devb-db/stm32_controller_v3/STM32_Controller_v3/STM32_Controller_v3.kicad_pcb

## KiCad design STM32_Controller_v3/STM32_Controller_v3.kicad_pcb (2026-06-17)

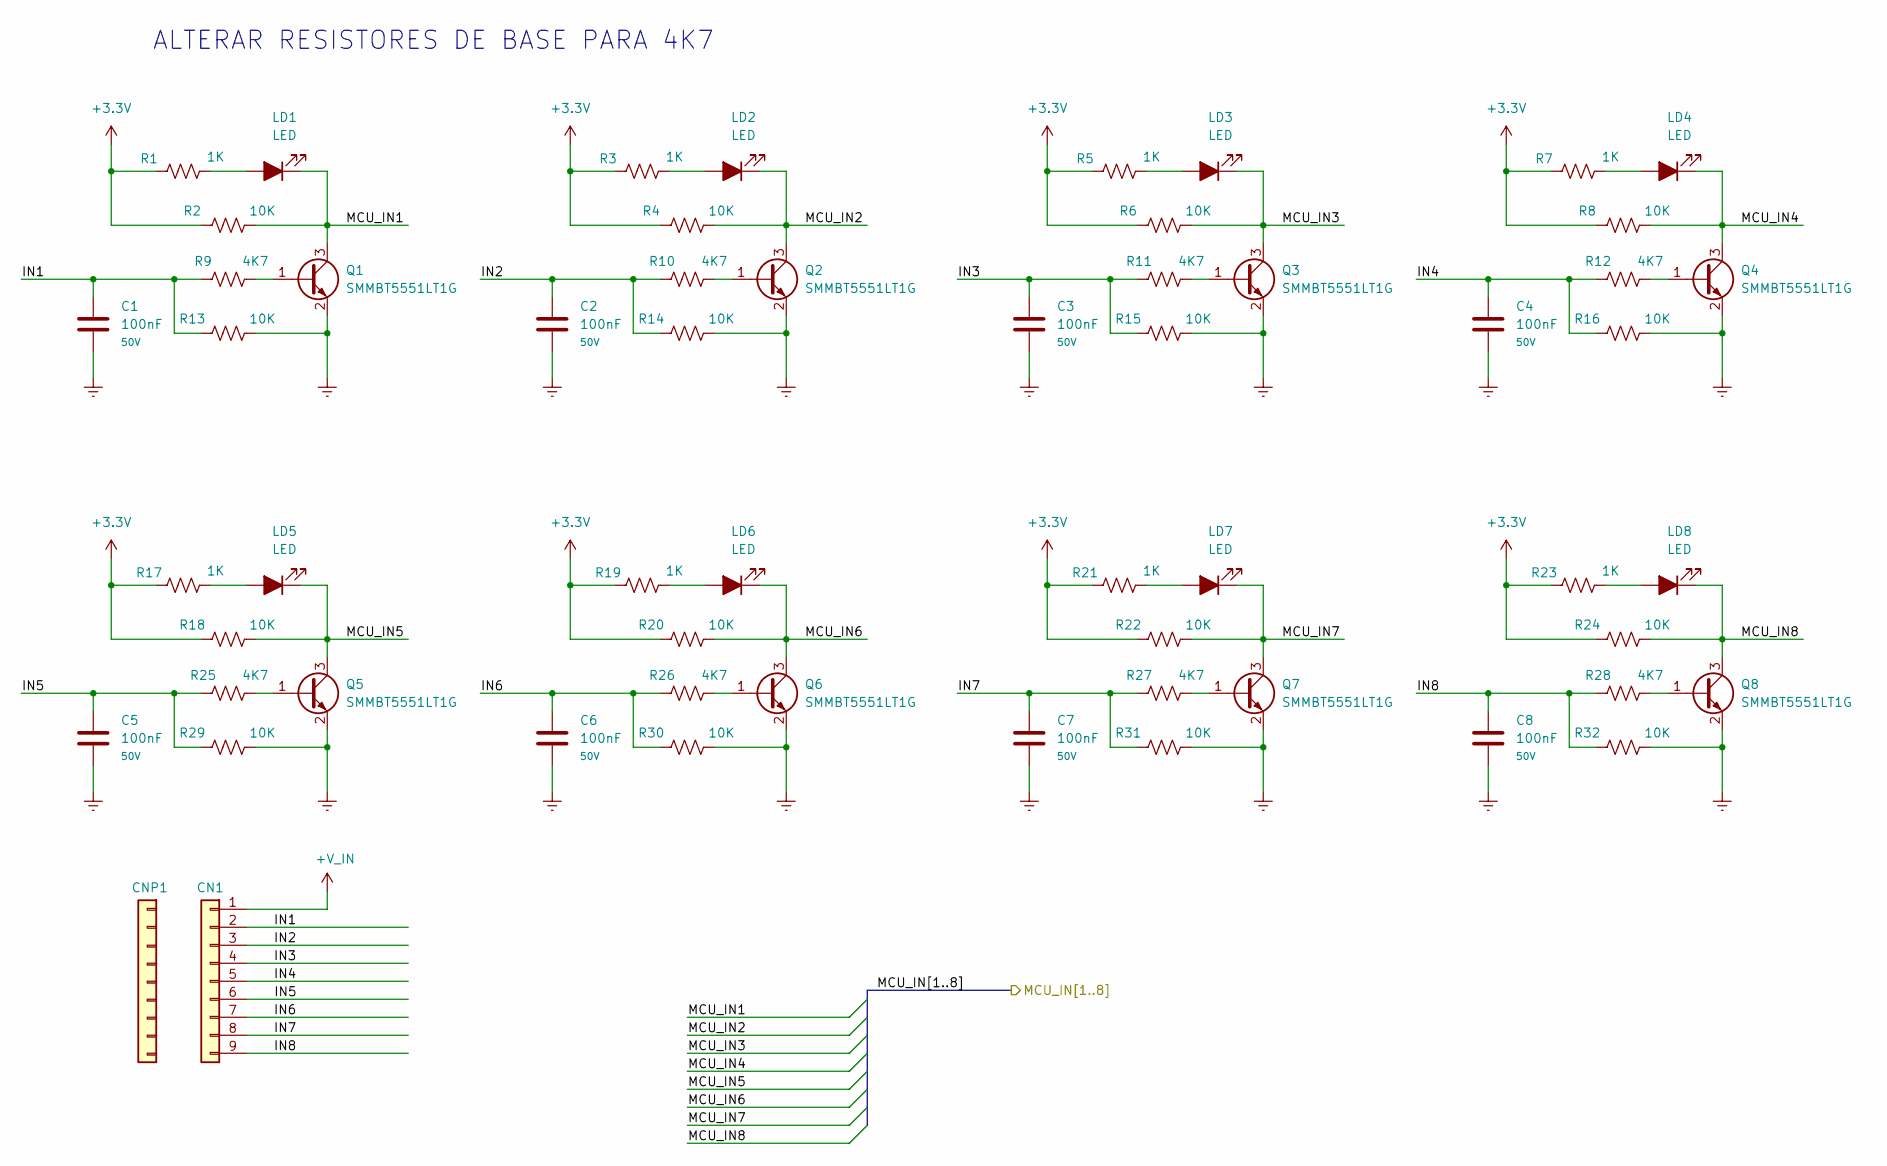
[picture p1: schematic Inputs_sch.kicad_sch]

Parts:
C1, C2, C3, C4, C5, C6, C7, C8: 100nF; C_0805; Voltage 50V; Part.Number CC0805KRX7R9BB104; LCSC Part C49678
CN1: WJ15EDGVC-3.81-09P-14-00A; PhoenixContact_MCV_1,5_9-G-3.81_1x09_P3.81mm_Vertical; Part.Number WJ15EDGVC-3.81-09P-14-00A; LCSC Part C49737
CNP1: WJ15EDGK-3.81-09P-14-00A; Part.Number WJ15EDGK-3.81-09P-14-00A; LCSC Part C31287
LD1, LD2, LD3, LD4, LD5, LD6, LD7, LD8: LED; LED_0805_2012Metric; Part.Number NCD0805R1; LCSC Part C84256
Q1, Q2, Q3, Q4, Q5, Q6, Q7, Q8: SMMBT5551LT1G; TSOT-23; Part.Number MMBT5551; LCSC Part C2145
R1, R3, R5, R7, R17, R19, R21, R23: 1K; R_0805; Part.Number 0805W8F1001T5E; LCSC Part C17513
R2, R4, R6, R8, R13, R14, R15, R16, R18, R20, R22, R24, R29, R30, R31, R32: 10K; R_0805; Part.Number 0805W8F1002T5E; LCSC Part C17414
R9, R10, R11, R12, R25, R26, R27, R28: 4K7; R_0805; LCSC Part C17673

Connections:
+3.3V: R1.1, R2.1, R3.1, R4.1, R5.1, R6.1, R7.1, R8.1, R17.1, R18.1, R19.1, R20.1, R21.1, R22.1, R23.1, R24.1; also elsewhere on the board
+V_IN: CN1.1; also elsewhere on the board
/Inputs/IN1: C1.1, CN1.2, R9.1, R13.1
/Inputs/IN2: C2.1, CN1.3, R10.1, R14.1
/Inputs/IN3: C3.1, CN1.4, R11.1, R15.1
/Inputs/IN4: C4.1, CN1.5, R12.1, R16.1
/Inputs/IN5: C5.1, CN1.6, R25.1, R29.1
/Inputs/IN6: C6.1, CN1.7, R26.1, R30.1
/Inputs/IN7: C7.1, CN1.8, R27.1, R31.1
/Inputs/IN8: C8.1, CN1.9, R28.1, R32.1
/Inputs/MCU_IN1: LD1.1 (K), Q1.3 (C), R2.2; also elsewhere on the board
/Inputs/MCU_IN2: LD2.1 (K), Q2.3 (C), R4.2; also elsewhere on the board
/Inputs/MCU_IN3: LD3.1 (K), Q3.3 (C), R6.2; also elsewhere on the board
/Inputs/MCU_IN4: LD4.1 (K), Q4.3 (C), R8.2; also elsewhere on the board
/Inputs/MCU_IN5: LD5.1 (K), Q5.3 (C), R18.2; also elsewhere on the board
/Inputs/MCU_IN6: LD6.1 (K), Q6.3 (C), R20.2; also elsewhere on the board
/Inputs/MCU_IN7: LD7.1 (K), Q7.3 (C), R22.2; also elsewhere on the board
/Inputs/MCU_IN8: LD8.1 (K), Q8.3 (C), R24.2; also elsewhere on the board
GND: C1.2, C2.2, C3.2, C4.2, C5.2, C6.2, C7.2, C8.2, Q1.2 (E), Q2.2 (E), Q3.2 (E), Q4.2 (E), Q5.2 (E), Q6.2 (E), Q7.2 (E), Q8.2 (E), R13.2, R14.2, R15.2, R16.2, R29.2, R30.2, R31.2, R32.2; also elsewhere on the board
unnamed: LD1.2 (A), R1.2
unnamed: LD2.2 (A), R3.2
unnamed: LD3.2 (A), R5.2
unnamed: LD4.2 (A), R7.2
unnamed: LD5.2 (A), R17.2
unnamed: LD6.2 (A), R19.2
unnamed: LD7.2 (A), R21.2
unnamed: LD8.2 (A), R23.2
unnamed: Q1.1 (B), R9.2
unnamed: Q2.1 (B), R10.2
unnamed: Q3.1 (B), R11.2
unnamed: Q4.1 (B), R12.2
unnamed: Q5.1 (B), R25.2
unnamed: Q6.1 (B), R26.2
unnamed: Q7.1 (B), R27.2
unnamed: Q8.1 (B), R28.2

Notes on the sheet:
ALTERAR RESISTORES DE BASE PARA 4K7

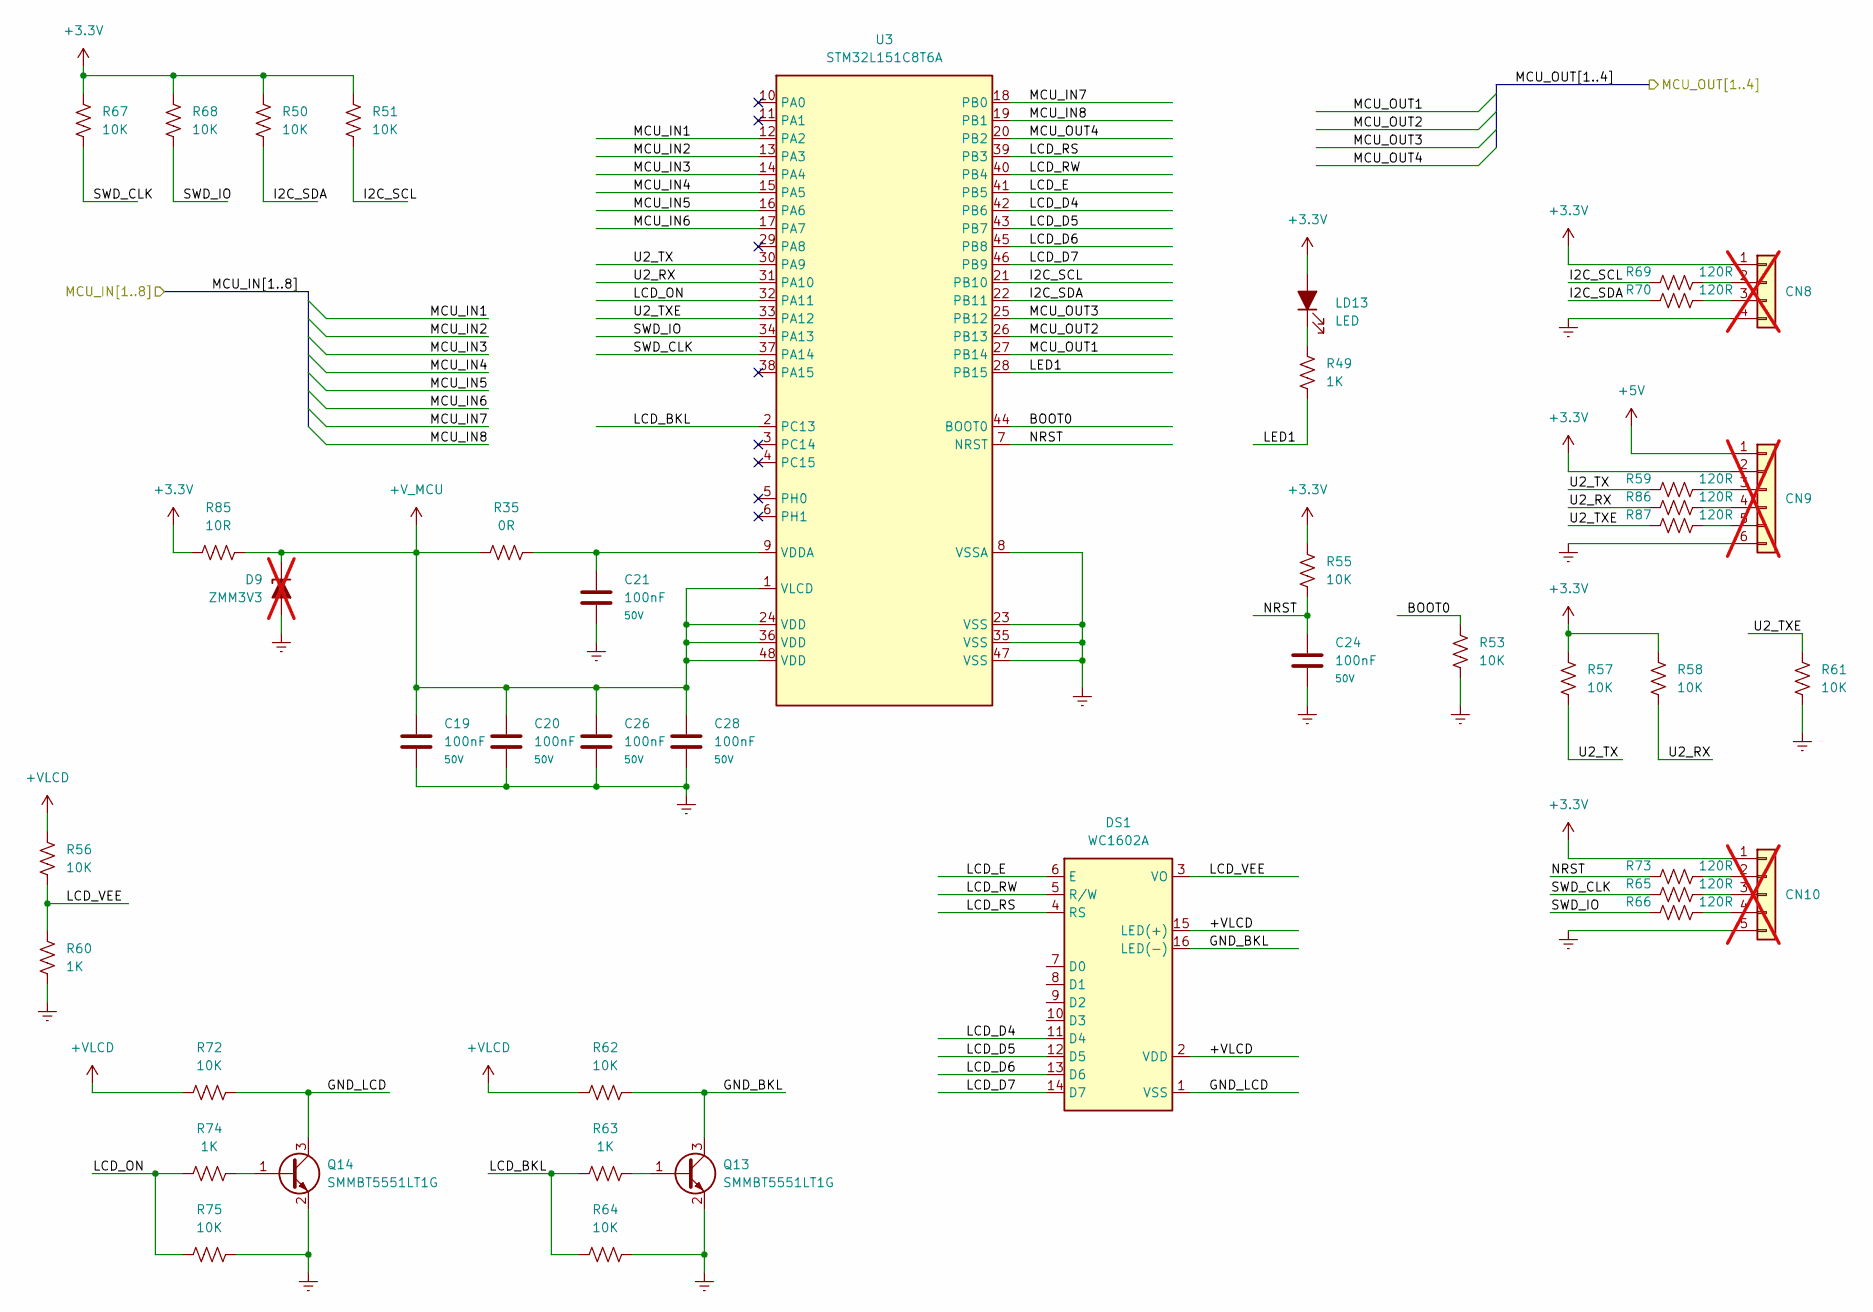
[picture p2: schematic Mcu_Stm32_sch.kicad_sch]

Parts:
C19, C20, C21, C24, C26, C28: 100nF; C_0805; Voltage 50V; Part.Number CC0805KRX7R9BB104; LCSC Part C49678
CN8: DS1021-1x4SF11-B; PinHeader_1x04_P2.54mm_Vertical; LCSC Part C7430360; not fitted
CN9: DS1021-1x6SF11-B; PinHeader_1x06_P2.54mm_Vertical; LCSC Part C7430362; not fitted
CN10: DS1021-1x5SF11-B; PinHeader_1x05_P2.54mm_Vertical; LCSC Part C7430361; not fitted
D9: ZMM3V3; D_MiniMELF; LCSC Part C8056; not fitted
DS1: WC1602A; Part.Number MGD1602A-NSW-BBS-01
LD13: LED; LED_0805_2012Metric; Part.Number NCD0805R1; LCSC Part C84256
Q13, Q14: SMMBT5551LT1G; TSOT-23; Part.Number MMBT5551; LCSC Part C2145
R35: 0R; R_0805; Part.Number 0805W8F0000T5E; LCSC Part C17477
R49, R60, R63, R74: 1K; R_0805; Part.Number 0805W8F1001T5E; LCSC Part C17513
R50, R51, R53, R55, R56, R57, R58, R61, R62, R64, R67, R68, R72, R75: 10K; R_0805; Part.Number 0805W8F1002T5E; LCSC Part C17414
R59, R65, R66, R69, R70, R73, R86, R87: 120R; R_0805; Part.Number 0805W8F1200T5E; LCSC Part C17437
R85: 10R; R_0805; Part.Number 0805W8F100JT5E; LCSC Part C17415
U3: STM32L151C8T6A; LQFP-48_7x7mm_P0.5mm; Part.Number STM32L151C8T6; LCSC Part C9861

Connections:
+3.3V: CN8.1, CN9.2, CN10.1, LD13.2 (A), R50.1, R51.1, R55.1, R57.1, R58.1, R67.1, R68.1, R85.1; also elsewhere on the board
+5V: CN9.1; also elsewhere on the board
+VLCD: DS1.2 (VDD), DS1.15 (LED(+)), R56.1, R62.1, R72.1; also elsewhere on the board
+V_MCU: C19.1, C20.1, C26.1, C28.1, D9.1 (K), R35.1, R85.2, U3.1 (VLCD), U3.24 (VDD), U3.36 (VDD), U3.48 (VDD)
/Inputs/MCU_IN1: U3.12 (PA2); also elsewhere on the board
/Inputs/MCU_IN2: U3.13 (PA3); also elsewhere on the board
/Inputs/MCU_IN3: U3.14 (PA4); also elsewhere on the board
/Inputs/MCU_IN4: U3.15 (PA5); also elsewhere on the board
/Inputs/MCU_IN5: U3.16 (PA6); also elsewhere on the board
/Inputs/MCU_IN6: U3.17 (PA7); also elsewhere on the board
/Inputs/MCU_IN7: U3.18 (PB0); also elsewhere on the board
/Inputs/MCU_IN8: U3.19 (PB1); also elsewhere on the board
/Mcu_Stm32/BOOT0: R53.1, U3.44 (BOOT0)
/Mcu_Stm32/GND_BKL: DS1.16 (LED(-)), Q13.3 (C), R62.2
/Mcu_Stm32/GND_LCD: DS1.1 (VSS), Q14.3 (C), R72.2
/Mcu_Stm32/I2C_SCL: R51.2, R69.1, U3.21 (PB10)
/Mcu_Stm32/I2C_SDA: R50.2, R70.1, U3.22 (PB11)
/Mcu_Stm32/LCD_BKL: R63.1, R64.1, U3.2 (PC13)
/Mcu_Stm32/LCD_D4: DS1.11 (D4), U3.42 (PB6)
/Mcu_Stm32/LCD_D5: DS1.12 (D5), U3.43 (PB7)
/Mcu_Stm32/LCD_D6: DS1.13 (D6), U3.45 (PB8)
/Mcu_Stm32/LCD_D7: DS1.14 (D7), U3.46 (PB9)
/Mcu_Stm32/LCD_E: DS1.6 (E), U3.41 (PB5)
/Mcu_Stm32/LCD_ON: R74.1, R75.1, U3.32 (PA11)
/Mcu_Stm32/LCD_RS: DS1.4 (RS), U3.39 (PB3)
/Mcu_Stm32/LCD_RW: DS1.5 (R/W), U3.40 (PB4)
/Mcu_Stm32/LCD_VEE: DS1.3 (VO), R56.2, R60.1
/Mcu_Stm32/LED1: R49.2, U3.28 (PB15)
/Mcu_Stm32/MCU_OUT1: U3.27 (PB14); also elsewhere on the board
/Mcu_Stm32/MCU_OUT2: U3.26 (PB13); also elsewhere on the board
/Mcu_Stm32/MCU_OUT3: U3.25 (PB12); also elsewhere on the board
/Mcu_Stm32/MCU_OUT4: U3.20 (PB2); also elsewhere on the board
/Mcu_Stm32/NRST: C24.1, R55.2, R73.1, U3.7 (NRST)
/Mcu_Stm32/SWD_CLK: R65.1, R67.2, U3.37 (PA14)
/Mcu_Stm32/SWD_IO: R66.1, R68.2, U3.34 (PA13)
/Mcu_Stm32/U2_RX: R58.2, R86.1, U3.31 (PA10)
/Mcu_Stm32/U2_TX: R57.2, R59.1, U3.30 (PA9)
/Mcu_Stm32/U2_TXE: R61.2, R87.1, U3.33 (PA12)
GND: C19.2, C20.2, C21.2, C24.2, C26.2, C28.2, CN8.4, CN9.6, CN10.5, D9.2 (A), Q13.2 (E), Q14.2 (E), R53.2, R60.2, R61.1, R64.2, R75.2, U3.8 (VSSA), U3.23 (VSS), U3.35 (VSS), U3.47 (VSS); also elsewhere on the board
unnamed: CN8.2, R69.2
unnamed: CN8.3, R70.2
unnamed: CN9.3, R59.2
unnamed: CN9.4, R86.2
unnamed: CN9.5, R87.2
unnamed: CN10.2, R73.2
unnamed: CN10.3, R65.2
unnamed: CN10.4, R66.2
unnamed: LD13.1 (K), R49.1
unnamed: Q13.1 (B), R63.2
unnamed: Q14.1 (B), R74.2
unnamed: C21.1, R35.2, U3.9 (VDDA)

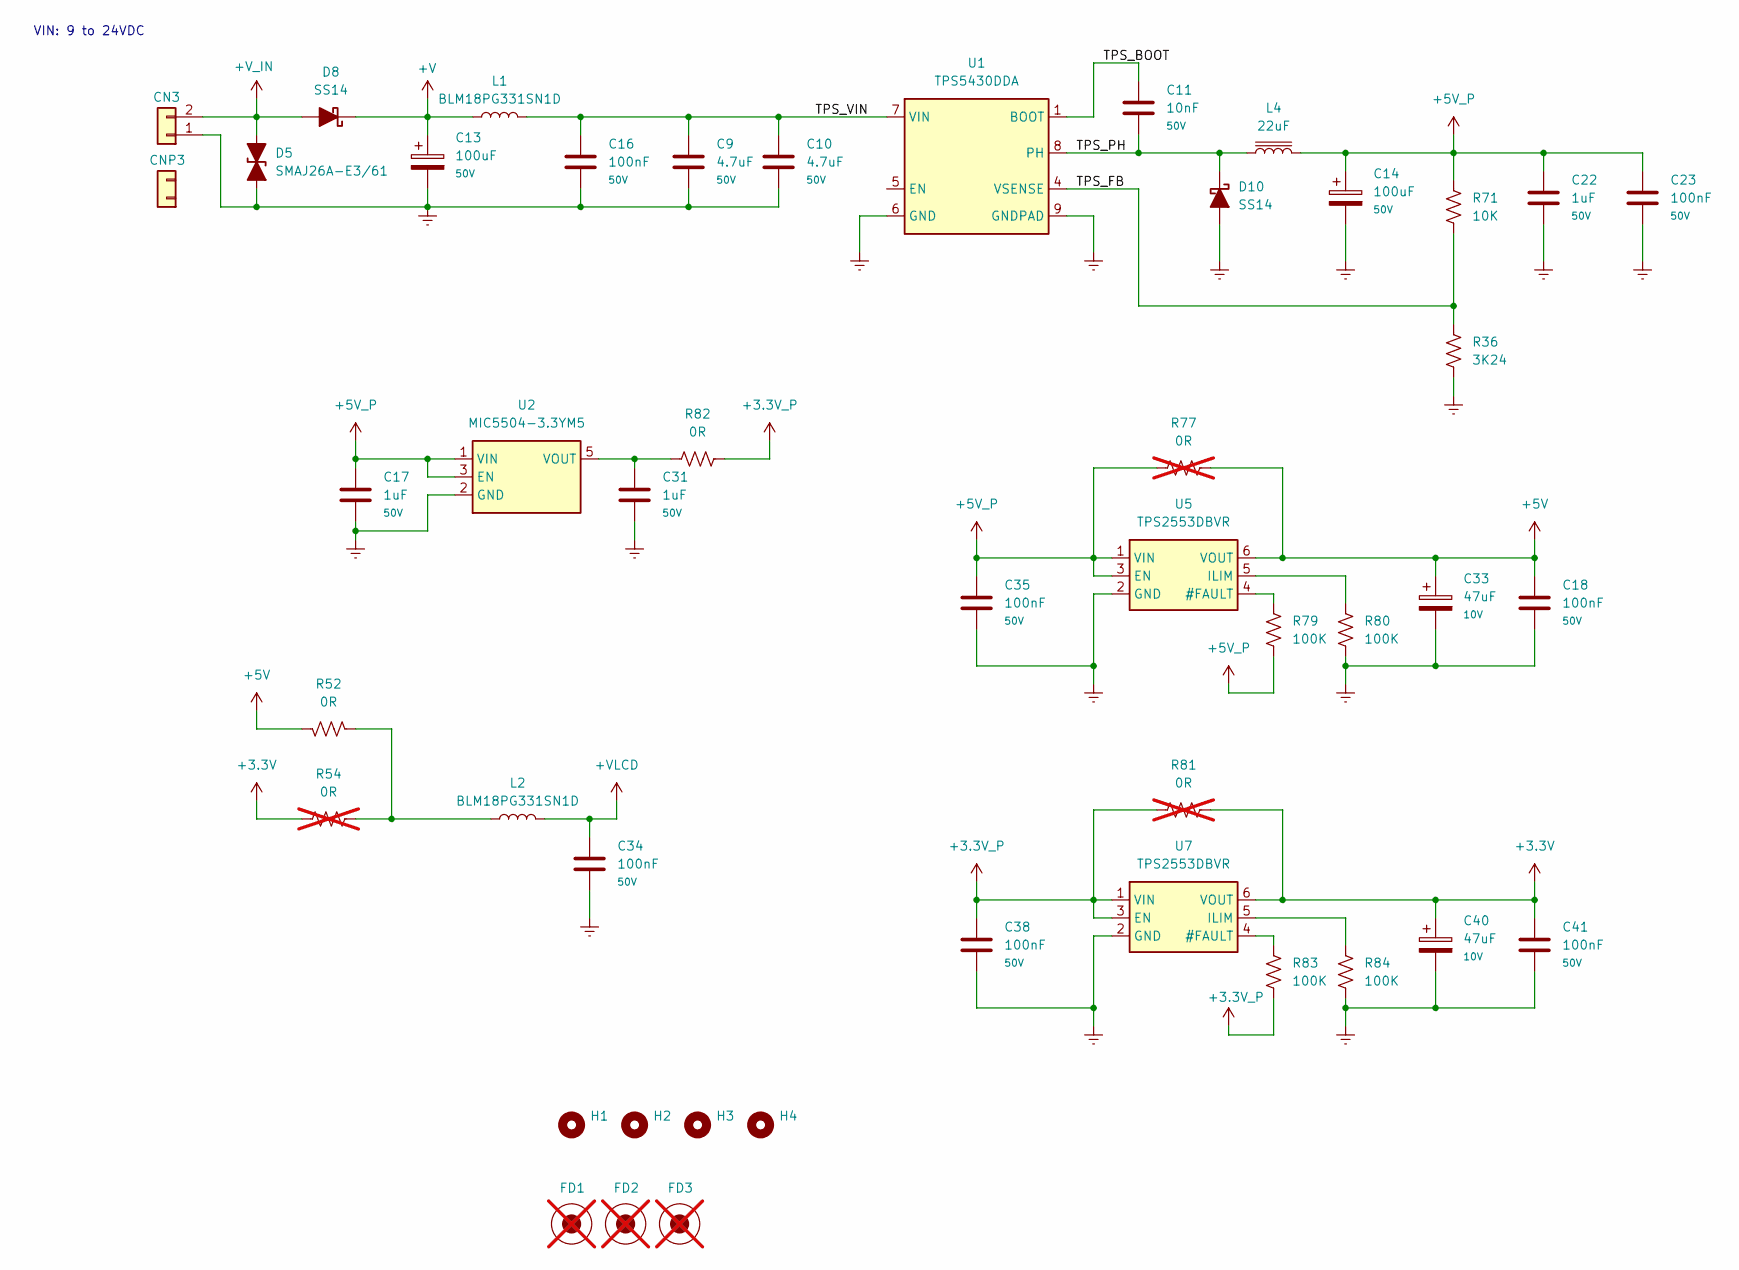
[picture p3: schematic Power_Supply_sch.kicad_sch]

Parts:
C9, C10: 4.7uF; C_1206; Voltage 50V; Part.Number 1206B475K500NT; LCSC Part C29823
C11: 10nF; C_0805; Voltage 50V; Part.Number CL21B103KBANNNC; LCSC Part C1710
C13, C14: 100uF; CP_Elec_8x10; Voltage 50V; Part.Number VEJ101M1HTR-0810L; LCSC Part C134502
C16, C18, C23, C34, C35, C38, C41: 100nF; C_0805; Voltage 50V; Part.Number CC0805KRX7R9BB104; LCSC Part C49678
C17, C22, C31: 1uF; C_0805; Voltage 50V; Part.Number CL21B105KBFNNNE; LCSC Part C28323
C33, C40: 47uF; CP_3528-CaseB; Voltage 10V; Part.Number TPSB476K010R0350; LCSC Part C444792
CN3: WJ15EDGVC-3.81-02P-14-00A; PhoenixContact_MCV_1,5_2-G-3.81_1x02_P3.81mm_Vertical; Part.Number WJ15EDGVC-3.81-02P-14-00A; LCSC Part C8396
CNP3: WJ15EDGK-3.81-02P-14-00A; Part.Number WJ15EDGK-3.81-02P-14-00A; LCSC Part C8466
D5: SMAJ26A-E3/61; D_SMA; Part.Number SMAJ26A; LCSC Part C49370
D8, D10: SS14; D_SMA; Part.Number SS14; LCSC Part C2480
FD1, FD2, FD3: FD; Fiducial_1mm_Mask3mm; not fitted
H1, H2, H3, H4: MountingHole; MountingHole_4.3mm_M4_Pad_Via
L1, L2: BLM18PG331SN1D; L_0603_1608Metric; Part.Number BLM18KG601SN1D; LCSC Part C85833
L4: 22uF; L_SMD_6x6x4.5mm; Part.Number FNR6045S220MT; LCSC Part C168080
R36: 3K24; R_0805; Part.Number 0805W8F3241T5E; LCSC Part C17609
R52, R82: 0R; R_0805; Part.Number 0805W8F0000T5E; LCSC Part C17477
R54, R77, R81: 0R; R_0805; LCSC Part C17477; not fitted
R71: 10K; R_0805; Part.Number 0805W8F1002T5E; LCSC Part C17414
R79, R80, R83, R84: 100K; R_0805; Part.Number RC0805FR-07100KL; LCSC Part C96346
U1: TPS5430DDA; TI_SO-PowerPAD-8_ThermalVias; Part.Number TPS5430DDAR; LCSC Part C9864
U2: MIC5504-3.3YM5; SOT-23-5; Part.Number MIC5504-3.3YM5-TR; LCSC Part C88419
U5, U7: TPS2553DBVR; SOT-23-6; Part.Number TPS2553DBVR; LCSC Part C55266

Connections:
+3.3V: C40.1, C41.1, R54.1, R81.2, U7.6 (VOUT); also elsewhere on the board
+3.3V_P: C38.1, R81.1, R82.2, R83.2, U7.1 (VIN), U7.3 (EN)
+5V: C18.1, C33.1, R52.2, R77.2, U5.6 (VOUT); also elsewhere on the board
+5V_P: C14.1, C17.1, C22.1, C23.1, C35.1, L4.2, R71.1, R77.1, R79.2, U2.1 (VIN), U2.3 (EN), U5.1 (VIN), U5.3 (EN)
+V: C13.1, D8.1 (K), L1.1
+VLCD: C34.1, L2.2; also elsewhere on the board
+V_IN: CN3.2, D5.2 (A2), D8.2 (A); also elsewhere on the board
/Power_Supply/TPS_BOOT: C11.1, U1.1 (BOOT)
/Power_Supply/TPS_FB: R36.1, R71.2, U1.4 (VSENSE)
/Power_Supply/TPS_PH: C11.2, D10.1 (K), L4.1, U1.8 (PH)
/Power_Supply/TPS_VIN: C9.1, C10.1, C16.1, L1.2, U1.7 (VIN)
GND: C9.2, C10.2, C13.2, C14.2, C16.2, C17.2, C18.2, C22.2, C23.2, C31.2, C33.2, C34.2, C35.2, C38.2, C40.2, C41.2, CN3.1, D5.1 (A1), D10.2 (A), R36.2, R80.2, R84.2, U1.6 (GND), U1.9 (GNDPAD), U2.2 (GND), U5.2 (GND), U7.2 (GND); also elsewhere on the board
unnamed: L2.1, R52.1, R54.2
unnamed: C31.1, R82.1, U2.5 (VOUT)
unnamed: R79.1, U5.4 (#FAULT)
unnamed: R80.1, U5.5 (ILIM)
unnamed: R83.1, U7.4 (#FAULT)
unnamed: R84.1, U7.5 (ILIM)

Notes on the sheet:
VIN: 9 to 24VDC

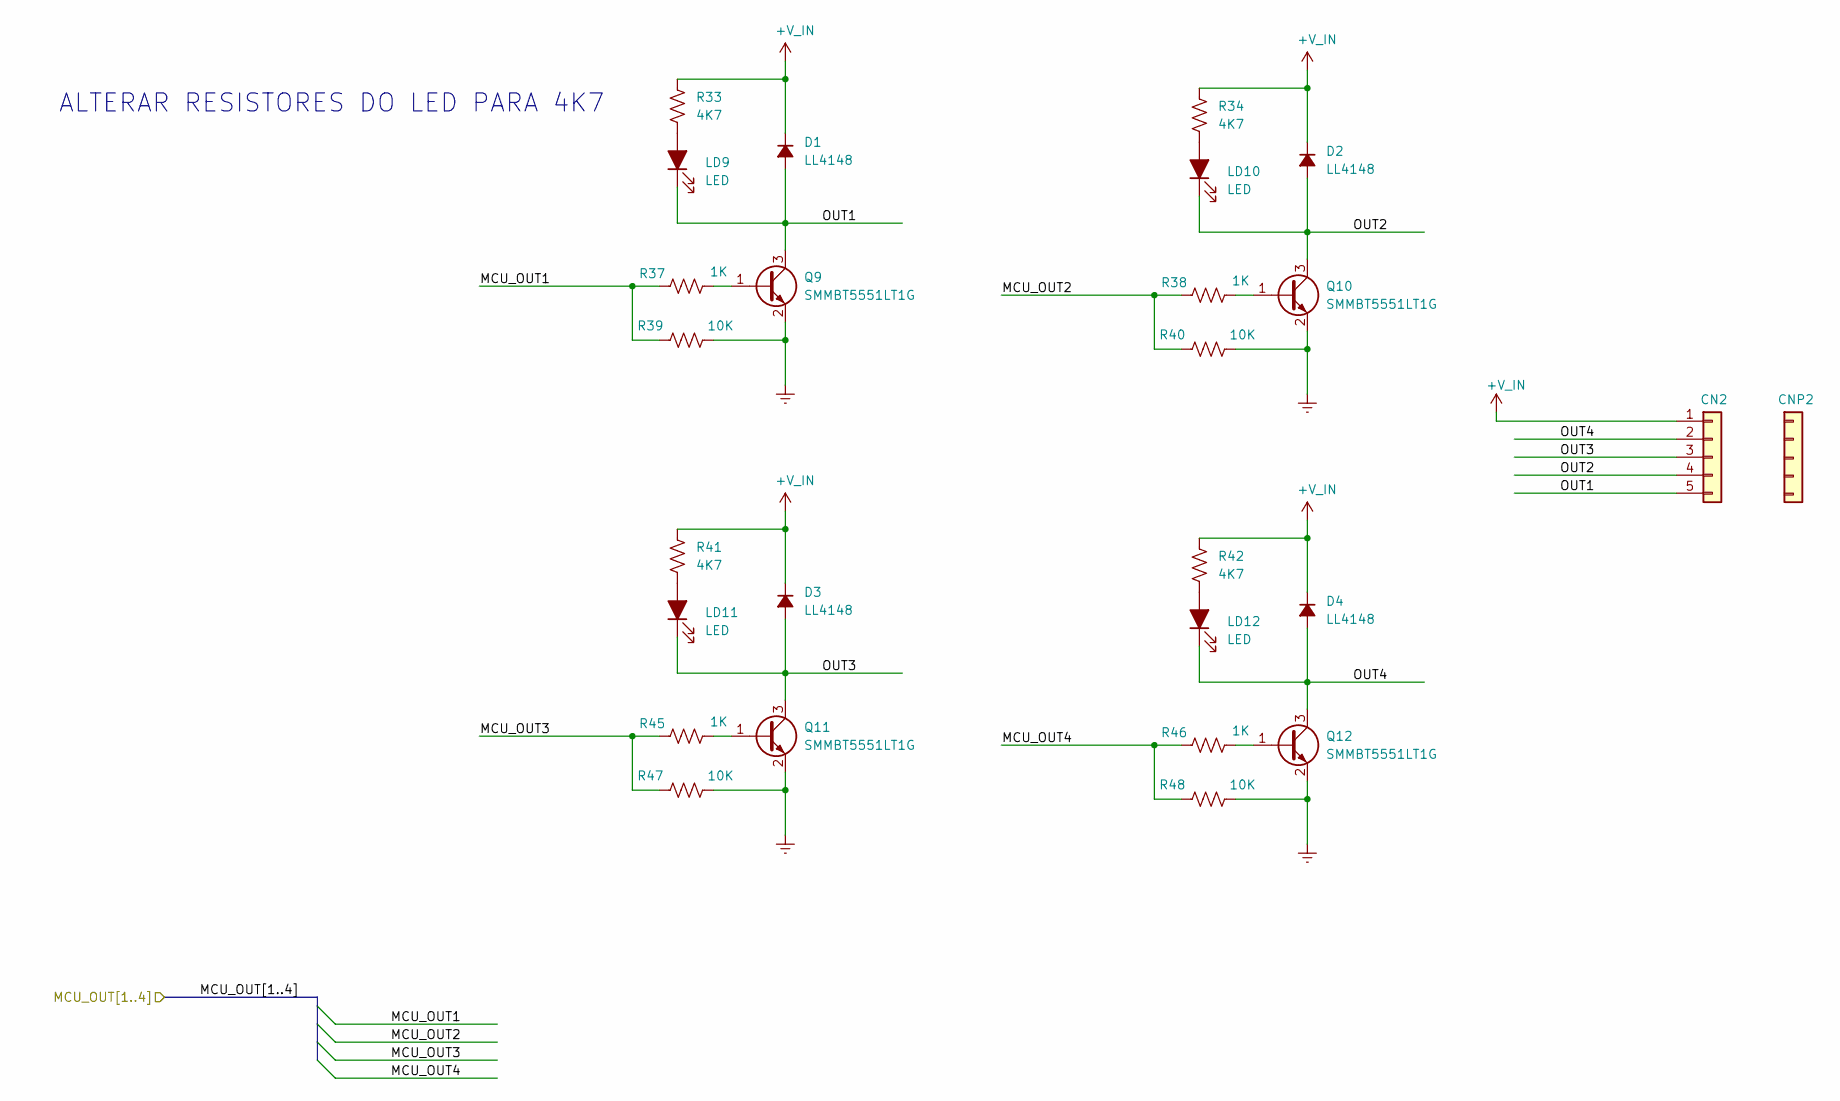
[picture p4: schematic Outputs_sch.kicad_sch]

Parts:
CN2: WJ15EDGVC-3.81-05P-14-00A; PhoenixContact_MCV_1,5_5-G-3.81_1x05_P3.81mm_Vertical; Part.Number WJ15EDGVC-3.81-05P-14-00A; LCSC Part C8391
CNP2: WJ15EDGK-3.81-05P-14-00A; Part.Number WJ15EDGK-3.81-05P-14-00A; LCSC Part C3804
D1, D2, D3, D4: LL4148; D_MiniMELF; Part.Number LL4148; LCSC Part C84062
LD9, LD10, LD11, LD12: LED; LED_0805_2012Metric; Part.Number NCD0805R1; LCSC Part C84256
Q9, Q10, Q11, Q12: SMMBT5551LT1G; TSOT-23; Part.Number MMBT5551; LCSC Part C2145
R33, R34, R41, R42: 4K7; R_0805; LCSC Part C17673
R37, R38, R45, R46: 1K; R_0805; Part.Number 0805W8F1001T5E; LCSC Part C17513
R39, R40, R47, R48: 10K; R_0805; Part.Number 0805W8F1002T5E; LCSC Part C17414

Connections:
+V_IN: CN2.1, D1.1 (K), D2.1 (K), D3.1 (K), D4.1 (K), R33.1, R34.1, R41.1, R42.1; also elsewhere on the board
/Mcu_Stm32/MCU_OUT1: R37.1, R39.1; also elsewhere on the board
/Mcu_Stm32/MCU_OUT2: R38.1, R40.1; also elsewhere on the board
/Mcu_Stm32/MCU_OUT3: R45.1, R47.1; also elsewhere on the board
/Mcu_Stm32/MCU_OUT4: R46.1, R48.1; also elsewhere on the board
/Outputs/OUT1: CN2.5, D1.2 (A), LD9.1 (K), Q9.3 (C)
/Outputs/OUT2: CN2.4, D2.2 (A), LD10.1 (K), Q10.3 (C)
/Outputs/OUT3: CN2.3, D3.2 (A), LD11.1 (K), Q11.3 (C)
/Outputs/OUT4: CN2.2, D4.2 (A), LD12.1 (K), Q12.3 (C)
GND: Q9.2 (E), Q10.2 (E), Q11.2 (E), Q12.2 (E), R39.2, R40.2, R47.2, R48.2; also elsewhere on the board
unnamed: LD9.2 (A), R33.2
unnamed: LD10.2 (A), R34.2
unnamed: LD11.2 (A), R41.2
unnamed: LD12.2 (A), R42.2
unnamed: Q9.1 (B), R37.2
unnamed: Q10.1 (B), R38.2
unnamed: Q11.1 (B), R45.2
unnamed: Q12.1 (B), R46.2

Notes on the sheet:
ALTERAR RESISTORES DO LED PARA 4K7

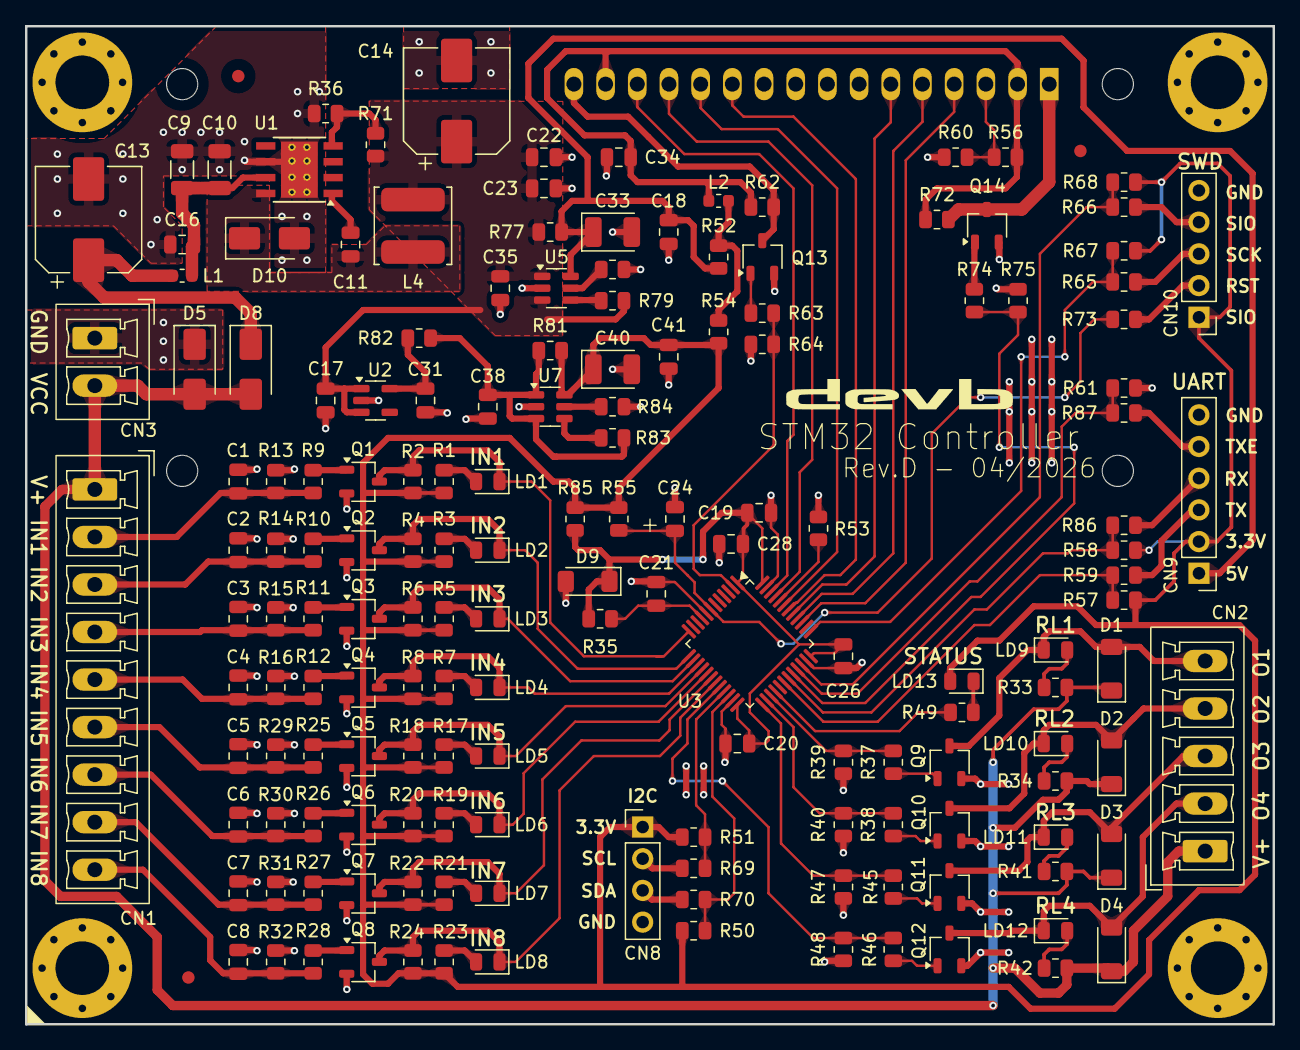
[picture p5: board STM32_Controller_v3.kicad_pcb from above]

Board: 2 copper layers, 100.0 x 80.0 mm, 172 parts (1 on the bottom side), 101 nets.

Other parts of the board:
G1: LOGO; logo_devb_h
