devb-db/stm32_controller_v3/(commit log)

2026-04-17 project upload
    [Inputs_sch.kicad_sch, Mcu_Stm32_sch.kicad_sch, Outputs_sch.kicad_sch, Power_Supply_sch.kicad_sch, STM32_Controller_v3.kicad_pcb, STM32_Controller_v3.kicad_sch]
2026-04-30 production version
    [BOM_JLC_FULL_no_display.xlsx, Inputs_sch.kicad_sch, Mcu_Stm32_sch.kicad_sch, Outputs_sch.kicad_sch, Power_Supply_sch.kicad_sch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]
2026-06-01 update dimension information
    [Inputs_sch.kicad_sch, Outputs_sch.kicad_sch, Power_Supply_sch.kicad_sch, STM32_Controller_v3.kicad_pcb]
2026-06-17 res 4k7 in digital inputs and outputs leds
    [BOM_JLC_FULL_no_display.xlsx, BOM_JLC_FULL_no_display_20260617.xlsx, Inputs_sch.kicad_sch, Outputs_sch.kicad_sch, Power_Supply_sch.kicad_sch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]
